cfrpg/Phibochilai-X/README.md

# Phibochilai X - "Kaniko"

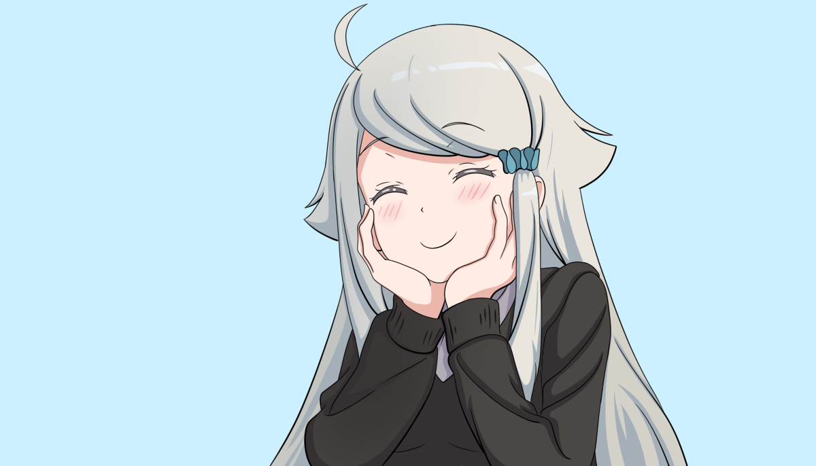
[picture p1: doc/65524353.jpg]
Image text


飞不起来10号

都出到10了吗?!

名字什么的先随便起一个好了

XFLR5 6.39

OpenVSP 3.13.1

CATIA V5r21

贴图：pid=65524353
