cfrpg/Phibochilai-X/cad/Structure/Deformation.png

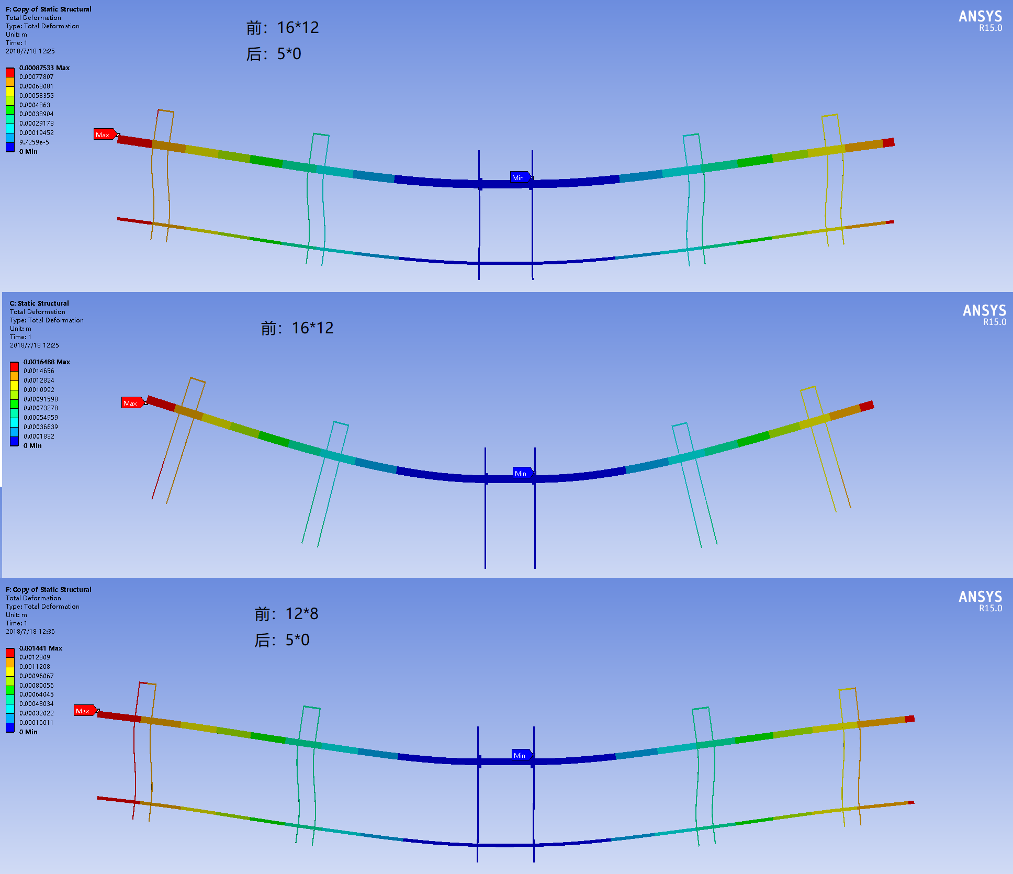
cad/Structure/Deformation.png
