cfrpg/Phibochilai-X/cad/法兰尺寸.png

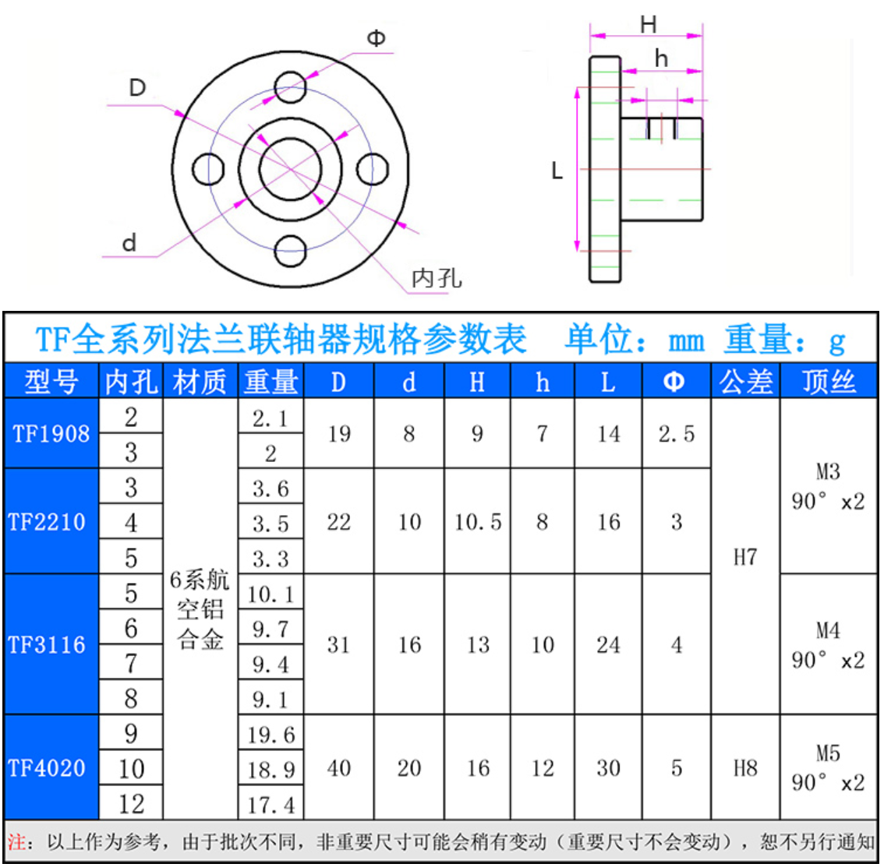
cad/法兰尺寸.png
