cfrpg/Phibochilai-X/doc/MotorMount.png

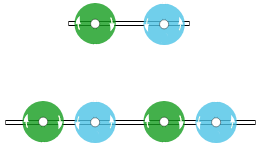
doc/MotorMount.png
