cfrpg/Phibochilai-X/vsp/kaniko.jpg

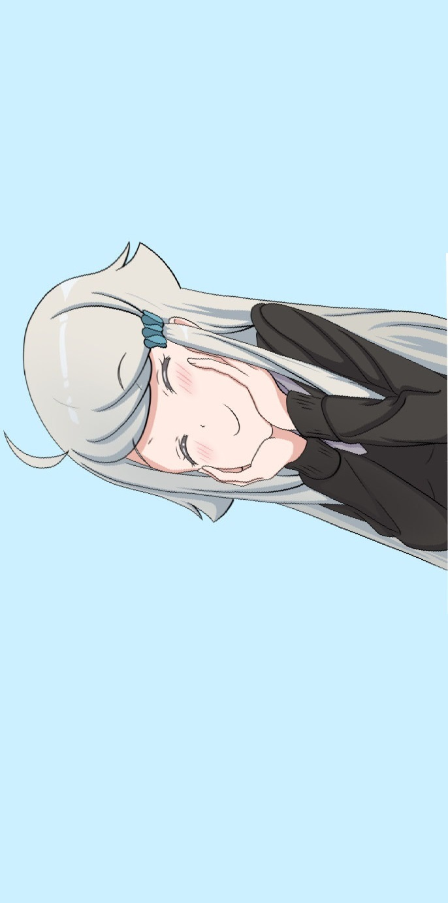
vsp/kaniko.jpg
