cfrpg/Phibochilai-X/doc/BOM.xlsx

Sheet: Sheet1
项目 | 型号 | 重量 | 数量 | 总重 | 单价 | 总价 | 含税 | 减重减配方案 | 备注
机翼电机 | TM 2214 | 60 | 6 | 360 | 599 | 1198 | 1317.8 | 没救 | 2.7kg@4s，买两套多两个或者买3套做两架
机翼电调 | TM 20A | 30 | 6 | 180 | 0 | 0 | 0 | 没救
机翼螺旋桨 | TM 1045 | 10 | 3 | 30 | 0 | 0 | 0 | 没救
舵面舵机 | 银燕ES3104 | 20 | 7 | 140 | 35 | 245 | 269.5 | 换成9g舵机 | 说不定用9g的就行
倾转套件 | 待定 | 50 | 2 | 100 | 300 | 600 | 660 | 可能还会增重 | 随便估算一下
接收机 | FUTABA R7008SB | 11 | 1 | 11 | 760 | 760 | 836 | 可以换成6303或者副厂
飞控 | Pixhawk(M8NGPS,数传电台) | 100 | 1 | 100 | 1422 | 1422 | 1564.2 | 乐迪Mini Pix有望轻几克
空速管 | 数字空速计 | 25 | 1 | 25 | 420 | 420 | 462 | 不装 | 破管子100多
电池 | 格氏4s5300mah 30c | 505 | 1 | 505 | 419 | 419 | 460.9 | 把电池里的铝板拆了 | 最好多买两块
电源 | 好盈UBEC 3A | 11 | 1 | 11 | 35 | 35 | 38.5 | 没救 | 不包括倾转用电力
起落架 | 起落架,机轮 | 50 | 1 | 50 | 20 | 20 | 22 | 自己拿kt板削 | 只留机轮
碳纤 | 碳纤管 | 400 | 1 | 400 | 300 | 300 | 330 | 设计高端结构 | 需要校核强度
板材 | 2mm kt板 | 33 | 10 | 330 | 10 | 100 | 110 | 大概可以铣薄减重？ | 2mm板，提高强度可以换成5mm打印店kt板
线材 | 电源线,信号线,插头等 | 250 | 1 | 250 | 50 | 50 | 55 | 没救 | 成吨的硅胶线
配件 | 螺丝,钢丝和轴承等 | 100 | 1 | 100 | 100 | 100 | 110 | 没救
3D打印耗材 | ABS，PLA，处理液 | 500 | 1 | 500 | 200 | 200 | 220 | 开减重孔 | 需要评估重量
其他耗材 | 胶水等 | 0 | 1 | 0 | 100 | 100 | 110 | 没救
总计 |  |  |  | 3092 |  | 5969 | 6565.9 |  | 这个重量真尴尬
假定超了20% |  |  |  | 3710.4
分类
动力 |  |  |  | 570 |  | 1198
电力 |  |  |  | 505 |  | 419
结构 |  |  |  | 1230 |  | 600
设备 |  |  |  | 437 |  | 3502
配件 |  |  |  | 350 |  | 250

Sheet: Sheet2
分类 | 项目 | 型号 | 单价 | 数量 | 总价 | 店铺 | 备注 | 链接
本体 | 舵面舵机 | ES3154 | 58 | 7 | 406 | 新动模型 |  | https://item.taobao.com/item.htm?spm=a1z10.3-c-s.w4002-14528659884.31.cd46829cfwxorK&id=21825583050
本体 | 动力电池 | 格氏4s5300mah30C | 419 | 2 | 838 | 新动模型 |  | https://item.taobao.com/item.htm?spm=a1z10.5-c-s.w4002-14528659934.20.4d405656KhgVBy&id=554987950181
本体 | 电源 | 好盈5V3A UBEC | 35 | 2 | 70 | 新动模型 |  | https://item.taobao.com/item.htm?spm=a1z10.3-c-s.w4002-14528659884.20.14e7829caOfjAF&id=567320340738
本体 | 接收机 | R6303SB | 425 | 1 | 425 | 朔天科技 |  | https://item.taobao.com/item.htm?spm=a1z0d.6639537.1997196601.26.302a7484ZEbE0i&id=559442696739
本体 | 倾转舵机 | JX 6221MG | 78 | 3 | 234 | 朔天科技 |  | https://item.taobao.com/item.htm?spm=a1z0d.6639537.1997196601.37.302a7484ZEbE0i&id=564749847613
本体 | 蜗轮蜗杆 | 待定 | 35 | 1 | 35 | 恒达传动 | 等舵机到货再买 | https://item.taobao.com/item.htm?spm=a230r.1.14.46.33266d23whc0w3&id=540207817197
本体 | 动力套 | TM 2214套装 | 649 | 2 | 1298 | TM专门店 |  | https://item.taobao.com/item.htm?spm=a1z10.5-c.w4002-4543554617.13.718966c6kBkGLw&id=23668976742
本体 | 飞控 | PixhackV3 | 1199 | 1 | 1199 | CUAV |  | https://item.taobao.com/item.htm?spm=a1z09.2.0.0.56292e8dlnoUTy&id=541167719476&_u=mmoj0iu0929
本体 | 空速计 | 全套 | 419 | 1 | 419 | CUAV |  | https://item.taobao.com/item.htm?id=9512463037&ns=1&abbucket=19
本体 | 数传 | 915mhz 250mw | 286 | 1 | 286 | CUAV |  | https://item.taobao.com/item.htm?spm=a1z09.2.0.0.56292e8dlnoUTy&id=15545763354&_u=mmoj0iu0bf3
材料 | 环氧 | 超级万能ab胶 | 10 | 1 | 10 | 新动模型 | orz | https://item.taobao.com/item.htm?spm=a1z0d.7625083.1998302264.5.686c4e69Y4uIfB&id=13570394121
材料 | 纤维胶带 | 30mm | 9 | 1 | 9 | 新动模型 |  | https://item.taobao.com/item.htm?spm=a1z10.5-c-s.w4002-14528659934.78.7bbcf351sMZeHS&id=13036166005
材料 | 热缩管 | 2mm | 0.5 | 2 | 1 | 新动模型 | 大口径的管够 | https://item.taobao.com/item.htm?spm=a1z10.5-c-s.w4002-14528659934.22.61a76a15HY9nIg&id=40865129513
材料 | 杜邦线 | 红黑白 | 1.5 | 10 | 15 | 新动模型 | 多多益善 | https://item.taobao.com/item.htm?spm=a1z10.5-c-s.w4002-14528659934.31.2228221cR54Bo0&id=14332242669
材料 | 电源线 | 16AWG | 2.35 | 6 | 14.1 | 新动模型 | 红黑 | https://item.taobao.com/item.htm?spm=a1z10.5-c-s.w4002-14528659934.37.6a2358c3eibgUb&id=14644636268
材料 | 电源线 | 18AWG | 1.65 | 4 | 6.6 | 新动模型 | 红黑 | https://item.taobao.com/item.htm?spm=a1z10.5-c-s.w4002-14528659934.37.6a2358c3eibgUb&id=14644636268
材料 | 泡沫板 | 2mm D板 | 54 | 2 | 108 | 添翼工作室 | 10张 | https://item.taobao.com/item.htm?spm=a1z10.5-c.w4002-844185206.18.1f9c14fcvGIe13&id=20099567300
材料 | 椴木层板 | 450*450*3 | 55 | 1 | 55 | 螃蟹王国 | 少量购买稍微贵点 | https://detail.tmall.com/item.htm?id=550455551745
材料 | 抛光液 | 500ml | 39 | 1 | 39 | 科瑞化工 | 当胶用 | https://item.taobao.com/item.htm?spm=a1z10.3-c.w4002-16599750469.23.eb1d69a0X7U7EI&id=561110898660
材料 | 泡沫胶 | UHU POR | 19.8 | 3 | 59.4 | XX办公 |  | https://detail.tmall.com/item.htm?id=15562625677&cm_id=140105335569ed55e27b&abbucket=19
材料 | 碳管 | 13*13*10 1m | 65 | 1 | 65 |  | 主梁内段 | https://item.taobao.com/item.htm?spm=a1z10.5-c.w4002-1768310787.59.6b6a6eabW4CycW&id=520294729905
材料 | 碳管 | 10*10*8 1m | 50 | 2 | 100 |  | 平尾粱，主梁外段 | https://item.taobao.com/item.htm?spm=a1z10.5-c.w4002-1768310787.47.6b6a6eabW4CycW&id=3938271944
材料 | 碳管 | 5*5*4 1m | 15 | 7 | 105 |  | 机身，后梁 | https://item.taobao.com/item.htm?spm=a1z0d.6639537.1997196601.4.16b274840PBlAP&id=13579665246
小配件 | 电池绑带 | 25cm | 2 | 1 | 2 | 新动模型 |  | https://item.taobao.com/item.htm?spm=a1z10.5-c-s.w4002-14528659934.62.7bbcf351sMZeHS&id=16015896454
小配件 | 电池插头 | XT60 | 3.2 | 4 | 12.8 | 新动模型 |  | https://item.taobao.com/item.htm?spm=a1z10.5-c-s.w4002-14528659934.57.5a57221ch5FilV&id=14867644853
小配件 | 分电板 |  | 3 | 1 | 3 | 新动模型 | 方便焊线 | https://item.taobao.com/item.htm?spm=a1z10.3-c-s.w4002-14528659884.11.5d76829cIV0MuB&id=13643634427
小配件 | 机轮 | 60*18,4mm | 3 | 4 | 12 | 新动模型 |  | https://item.taobao.com/item.htm?spm=a1z10.5-c-s.w4002-14528659934.23.40f772a7XnDLo2&id=13408709705
小配件 | 轮档 | 4.1mm | 0.6 | 5 | 3 | 新动模型 | 多买一个防止丢了 | https://item.taobao.com/item.htm?spm=a1z10.5-c-s.w4002-14528659934.19.40f772a7XnDLo2&id=14915104265
小配件 | 轮轴 | D4M5L27 | 3 | 4 | 12 | 新动模型 |  | https://item.taobao.com/item.htm?spm=a1z10.5-c-s.w4002-14528659934.31.40f772a7XnDLo2&id=14404690920
小配件 | 舵角套装 | 舵角+夹头 | 0.6 | 10 | 6 | 新动模型 |  | https://item.taobao.com/item.htm?spm=a1z10.5-c-s.w4002-14528659934.26.13e9121csnCs3k&id=18969440483
小配件 | 快调 | 1.6mm | 1 | 10 | 10 | 新动模型 |  | https://item.taobao.com/item.htm?spm=a1z10.5-c-s.w4002-14528659934.32.13e9121csnCs3k&id=13513525421
小配件 | 调直钢丝 | 1.2*65 | 14 | 1 | 14 | 新动模型 | 大概是10根 | https://item.taobao.com/item.htm?spm=a1z10.3-c-s.w4002-14528659884.10.560d829cXNa1HR&id=17062142989
小配件 | 螺母 | 20*M5 | 6 | 1 | 6 | 新动模型 | 轮轴用 | https://item.taobao.com/item.htm?spm=a1z10.3-c-s.w4002-14528659884.10.560d829cXNa1HR&id=17062142989
小配件 | 螺丝 | M3*8 | 0.45 | 30 | 13.5 | 新动模型 |  | https://item.taobao.com/item.htm?spm=a1z10.5-c-s.w4002-14528659934.80.dfc5526c4CaVA9&id=38307536599
小配件 | 螺丝 | M3*20 | 0.6 | 10 | 6 | 新动模型 | 连接用 | https://item.taobao.com/item.htm?spm=a1z10.5-c-s.w4002-14528659934.48.5dc3526cCjNvaT&id=14641396282
小配件 | 螺丝 | 10*M2*16 | 5 | 2 | 10 | 朔天科技 |  | https://item.taobao.com/item.htm?spm=a1z0d.6639537.1997196601.15.302a7484ZEbE0i&id=559596965276
小配件 | 螺母 | M2 | 100 | 0.02 | 2 | 朔天科技 |  | https://item.taobao.com/item.htm?spm=a1z0d.6639537.1997196601.4.302a7484ZEbE0i&id=565092035559
运费 |  |  | 20 | 1 | 20 | 添翼工作室
运费 |  |  | 7 | 1 | 7 | 新动模型
运费 |  |  | 26 | 1 | 26 | CUAV | 坑b卖家，记下了
总计 |  |  |  |  | 5962.4
