cfrpg/Phibochilai-X/doc/重量估算.xlsx

Sheet: 4s 2214配置
分项 |  | 质量(g) | 数量 | 总重(g) | 单价(CNY) | 总价(CNY) | 备注
电机 | TM 2214 | 60 | 4 | 240 | 0 | 599 | 2.2-4.8kg拉力@4s
电调 | TM20A | 30 | 4 | 120 | 0 | 0 | 套装
桨 | TM1045 | 10 | 4 | 40 | 0 | 0 | 套装
尾部电机 | 朗宇X2216 | 72 | 1 | 72 | 85 | 85 | 后出轴
尾部电调 | 好盈铂金40A | 40 | 1 | 40 | 143 | 143
舵面舵机 | 银燕9g塑料 | 10 | 7 | 70 | 17 | 119 | 有涨价的趋势
电池 | 格式4s5300 | 505 | 1 | 505 | 420 | 420 | 或2200*2,或4s
倾转舵机 | KST | 60 | 2 | 120 | 300 | 600 | 大扭力
飞控 | pix全套 | 150 | 1 | 150 | 1500 | 1500 | GPS空速管数传
尾部总成 | 自制(450级尾部) | 30 | 2 | 60 | 250 | 500 | 按照亚拓450估算的价格
碳 | 碳管 | 200 | 1 | 200 | 100 | 100 | 机翼梁和尾翼粱
钢 | 钢丝,轴 | 100 | 1 | 100 | 100 | 100 | 没有经验,难以估算
板 | 2mm kt板 | 33 | 10 | 330 | 10 | 100 | 大概需要10张,也有3mm的d板
3D打印件 | ABS | 400 | 1 | 400 | 60 | 60 | 初步估算重量,一卷耗材的价格
轴承 |  | 100 | 1 | 100 | 100 | 100 | 估算
胶 | UHU por,热熔胶等 | 40 | 1 | 40 | 25 | 25 | 用一管胶差不多够了
总计 |  |  |  | 2587 |  | 4451
考虑各种影响因素 |  |  |  | 3104.4 |  | 5341.2 | 超重,运费和发票20%
分类
动力 |  |  |  | 512 |  | 827
电力 |  |  |  | 505 |  | 420
机构 |  |  |  | 380 |  | 1300
电子设备 |  |  |  | 220 |  | 1619
结构 |  |  |  | 970 |  | 285

Sheet: 3508配置
分项 |  | 质量(g) | 数量 | 总重(g) | 单价(CNY) | 总价(CNY) | 备注
电机 | TM 3508 Kv700 | 82 | 4 | 328 | 399 | 1596 | 2.8(60%)-5.4kg(100%)推力
电调 | 好盈乐天40A | 30 | 4 | 120 | 62 | 248 | TM电调一个230,经费花不完可以换
桨 | TM12*4CF | 14 | 4 | 56 | 125 | 500 | emmmm,氪金帝都炸不起
尾部电机 | 朗宇X2216 | 72 | 1 | 72 | 85 | 85 | 后出轴
尾部电调 | 好盈铂金40A | 40 | 1 | 40 | 143 | 143
舵面舵机 | ES3104 | 20 | 7 | 140 | 35 | 245
电池 | 格式4s5300 | 505 | 1 | 505 | 420 | 420
倾转舵机 | KST | 70 | 2 | 140 | 400 | 800 | 大扭力
飞控 | pix全套 | 150 | 1 | 150 | 1500 | 1500 | GPS空速管数传
尾部总成 | 自制(450级尾部) | 30 | 2 | 60 | 250 | 500 | 按照亚拓450估算的价格
碳 | 碳管 | 200 | 1 | 200 | 100 | 100 | 机翼梁和尾翼粱
钢 | 钢丝,轴 | 100 | 1 | 100 | 100 | 100 | 没有经验,难以估算
板 | 2mm kt板 | 33 | 10 | 330 | 10 | 100 | 大概需要10张
3D打印件 | ABS | 500 | 1 | 500 | 60 | 60 | 初步估算重量,一卷耗材的价格
轴承 |  | 100 | 1 | 100 | 100 | 100 | 估算
胶 | UHU por,热熔胶等 | 40 | 1 | 40 | 25 | 25 | 用一管胶差不多够了
总计 |  |  |  | 2881 |  | 6522
考虑各种影响因素 |  |  |  | 3457.2 |  | 7826.4 | 超重,运费和发票20%
分类
动力 |  |  |  | 616 |  | 2572
电力 |  |  |  | 505 |  | 420
机构 |  |  |  | 400 |  | 1500
电子设备 |  |  |  | 290 |  | 1745
结构 |  |  |  | 1070 |  | 285

Sheet: u3配置
分项 |  | 质量(g) | 数量 | 总重(g) | 单价(CNY) | 总价(CNY) | 备注
电机 | TM U3 | 100 | 4 | 400 | 699 | 2796 | 4.0(60%)-7.2kg(100%)推力,动力澎湃
电调 | 好盈乐天40A | 30 | 4 | 120 | 62 | 248 | TM电调一个230,经费花不完可以换
桨 | TM13*4.4CF | 16 | 4 | 64 | 135 | 540 | emmmm,氪金帝都炸不起
尾部电机 | 朗宇X2820 | 143 | 1 | 143 | 150 | 150 | 后出轴
尾部电调 | 好盈飞腾60A | 70 | 1 | 70 | 200 | 200
舵面舵机 | ES3104 | 20 | 7 | 140 | 35 | 245
电池 | 格式4s5300 | 505 | 1 | 505 | 420 | 420
倾转舵机 | KST | 70 | 2 | 140 | 400 | 800 | 大扭力
飞控 | pix全套 | 150 | 1 | 150 | 1500 | 1500 | GPS空速管数传
尾部总成 | 自制(~700级尾部) | 60 | 2 | 120 | 400 | 800 | 可能需要大一点的尾桨
碳 | 碳管 | 300 | 1 | 300 | 100 | 100 | 机翼梁和尾翼粱
钢 | 钢丝,轴 | 100 | 1 | 100 | 100 | 100 | 没有经验,难以估算
板 | 2mm kt板 | 33 | 10 | 330 | 10 | 100 | 大概需要10张
3D打印件 | ABS | 600 | 1 | 600 | 60 | 60 | 初步估算重量,一卷耗材的价格
轴承 |  | 100 | 1 | 100 | 100 | 100 | 估算
胶 | UHU por,热熔胶等 | 40 | 1 | 40 | 25 | 25 | 用一管胶差不多够了
总计 |  |  |  | 3322 |  | 8184
考虑各种影响因素 |  |  |  | 3986.4 |  | 9820.8 | 超重,运费和发票20%
分类
动力 |  |  |  | 797 |  | 3934
电力 |  |  |  | 505 |  | 420
机构 |  |  |  | 460 |  | 1800
电子设备 |  |  |  | 290 |  | 1745
结构 |  |  |  | 1270 |  | 285
