cfrpg/Phibochilai-X/cad/3DPrint/GearFrame.stl

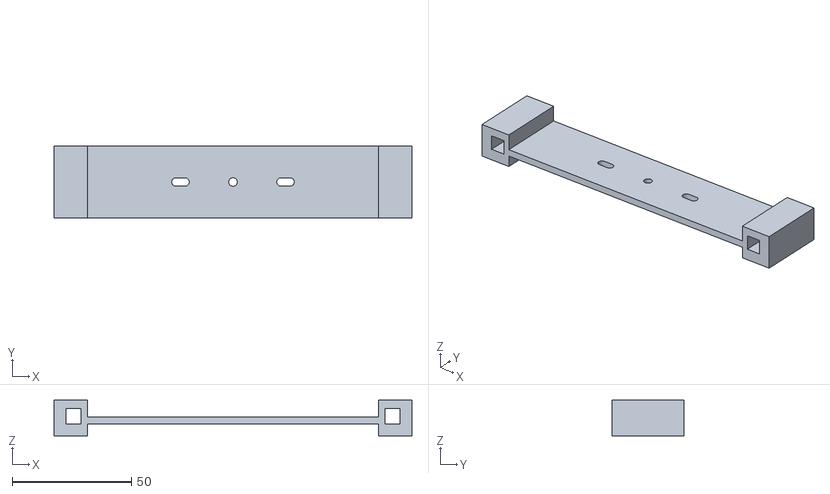
[picture p17: CAD file, 2018-12-05]
cad/3DPrint/GearFrame.stl
150.0 x 30.0 x 15.0
