cfrpg/Phibochilai-X/cad/3DPrint/servo/holder3.stl

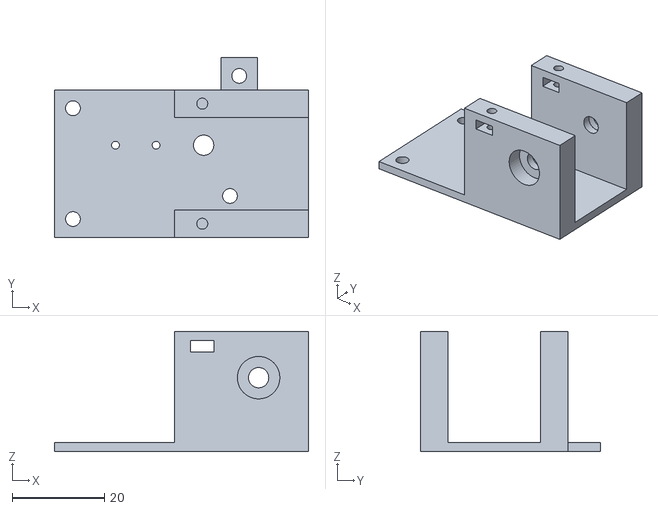
[picture p18: CAD file, 2018-12-05]
cad/3DPrint/servo/holder3.stl
55.0 x 39.0 x 26.0
