cfrpg/Phibochilai-X/cad/3DPrint/test/fakeWingFrame.stl

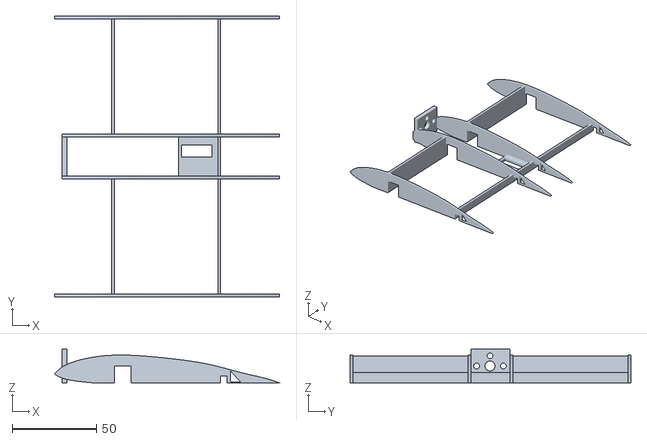
[picture p19: CAD file, 2018-07-22]
cad/3DPrint/test/fakeWingFrame.stl
133.5 x 166.6 x 20.0
