cfrpg/Phibochilai-X/cad/3DPrint/test/fakeWingSet/fakebeam.stl

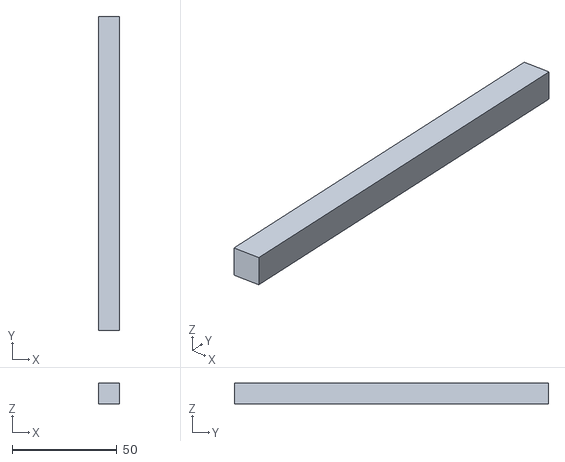
[picture p20: CAD file, 2018-03-03]
cad/3DPrint/test/fakeWingSet/fakebeam.stl
10.0 x 150.0 x 10.0
