cfrpg/Phibochilai-X/cad/3DPrint/TiltFrame/servoFrame.stl

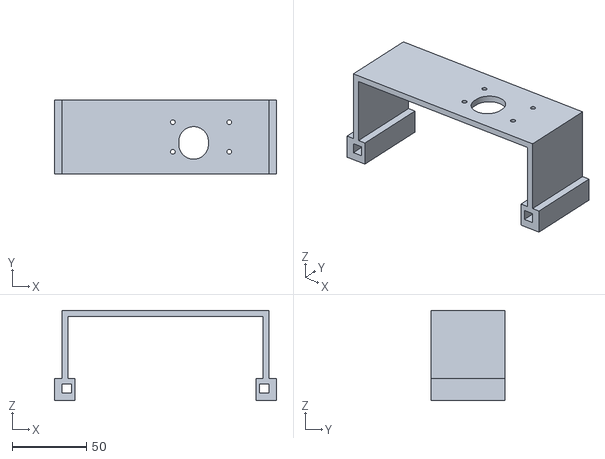
[picture p21: CAD file, 2018-10-30]
cad/3DPrint/TiltFrame/servoFrame.stl
150.0 x 50.0 x 61.0
