cfrpg/Phibochilai-X/cad/model/model.igs

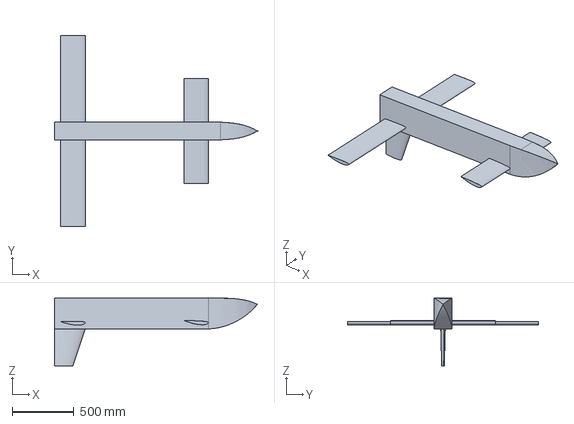
[picture p22: CAD file, 2018-10-06]
cad/model/model.igs
1650.0 x 1550.0 x 550.0 mm
