cfrpg/Phibochilai-X/cad/3DPrint/gearMount.stl

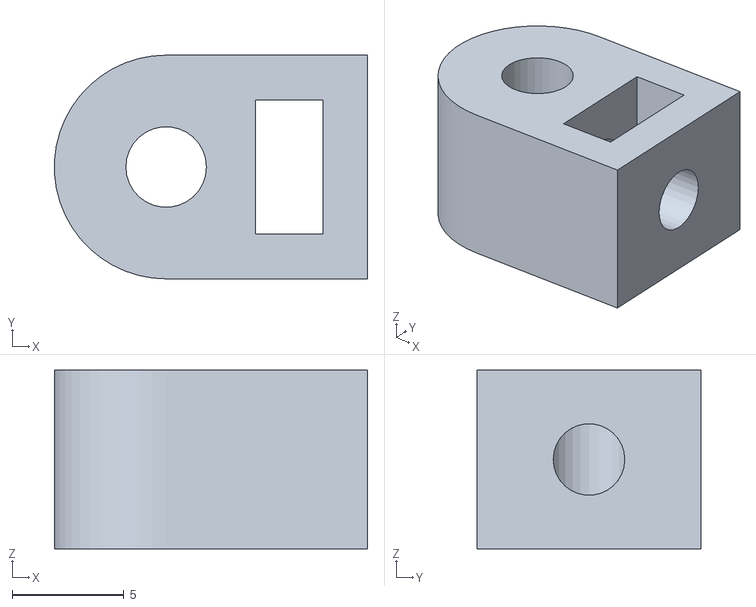
[picture p23: CAD file, 2018-12-05]
cad/3DPrint/gearMount.stl
14.0 x 10.0 x 8.00
