cfrpg/Phibochilai-X/cad/3DPrint/servo/pdGear.stl

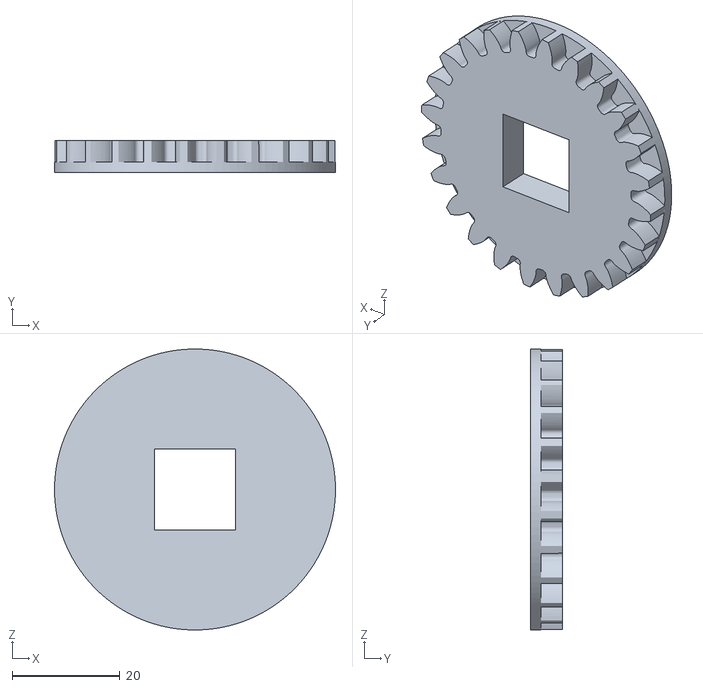
[picture p24: CAD file, 2018-12-05]
cad/3DPrint/servo/pdGear.stl
52.0 x 6.00 x 52.0
