cfrpg/Phibochilai-X/cad/3DPrint/test/compMount.stl

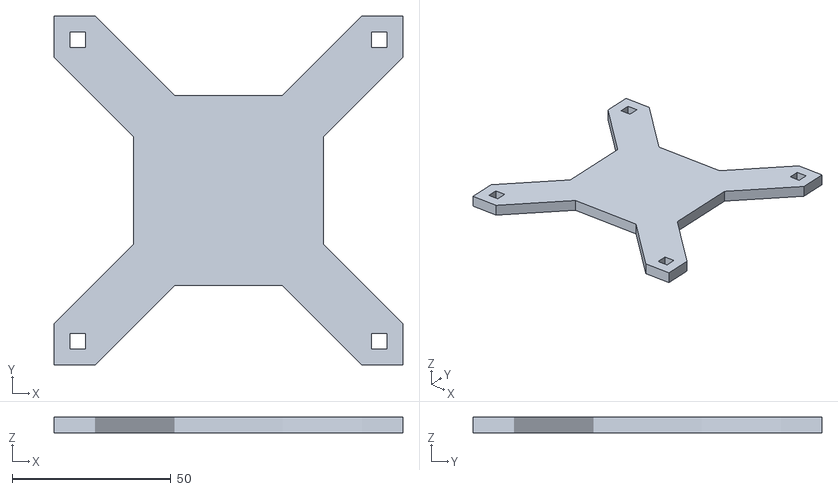
[picture p25: CAD file, 2018-07-15]
cad/3DPrint/test/compMount.stl
110.0 x 110.0 x 5.00
