cfrpg/Phibochilai-X/cad/3DPrint/test/fakeWingSet/fakesleevecap.stl

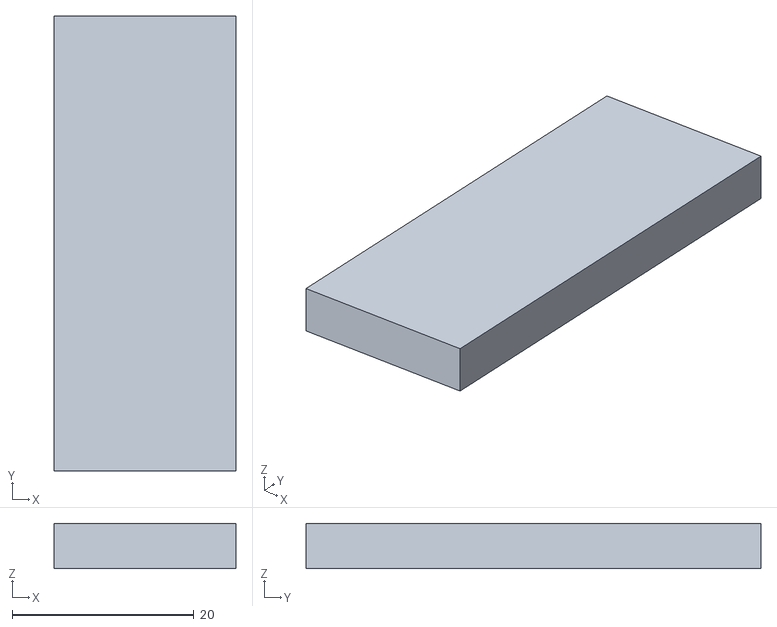
[picture p26: CAD file, 2018-03-03]
cad/3DPrint/test/fakeWingSet/fakesleevecap.stl
20.0 x 50.0 x 5.00
