cfrpg/Phibochilai-X/cad/3DPrint/TiltFrame/aaa.stl

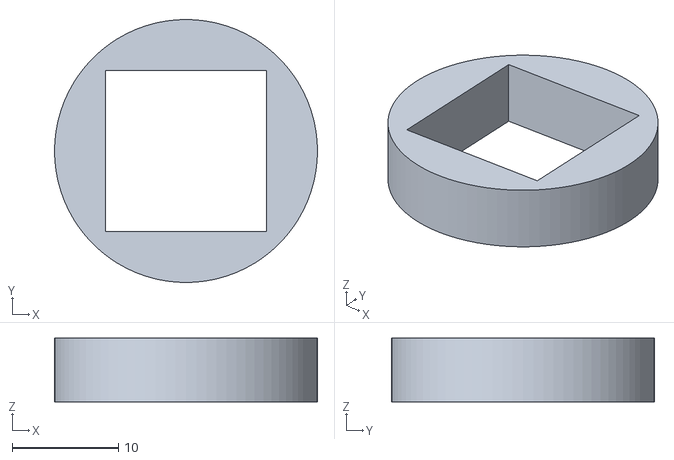
[picture p27: CAD file, 2018-10-30]
cad/3DPrint/TiltFrame/aaa.stl
24.8 x 24.8 x 6.00
