cfrpg/Phibochilai-X/cad/3DPrint/servo/base3.stl

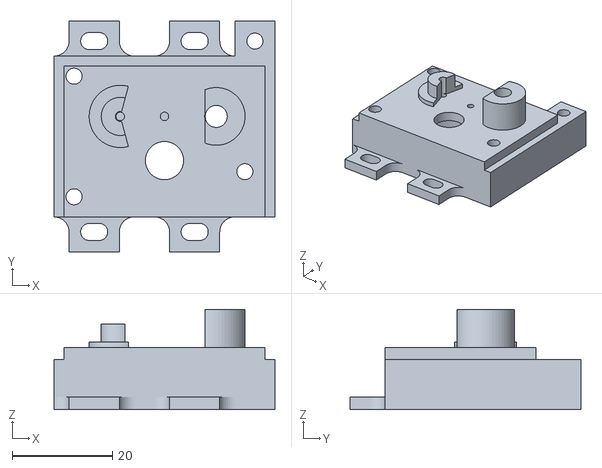
[picture p28: CAD file, 2018-12-05]
cad/3DPrint/servo/base3.stl
44.0 x 46.0 x 20.0
