cfrpg/Phibochilai-X/cad/3DPrint/test/fakeWingSet/fakesleeve.stl

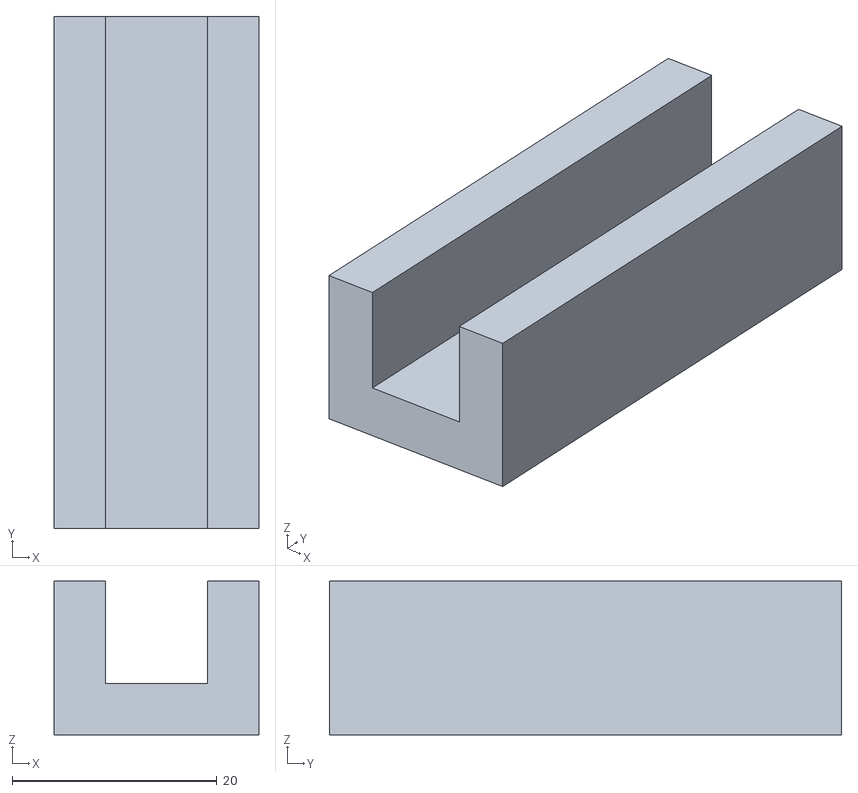
[picture p29: CAD file, 2018-03-03]
cad/3DPrint/test/fakeWingSet/fakesleeve.stl
20.0 x 50.0 x 15.0
