cfrpg/Phibochilai-X/cad/3DPrint/test/strengthTest.stl

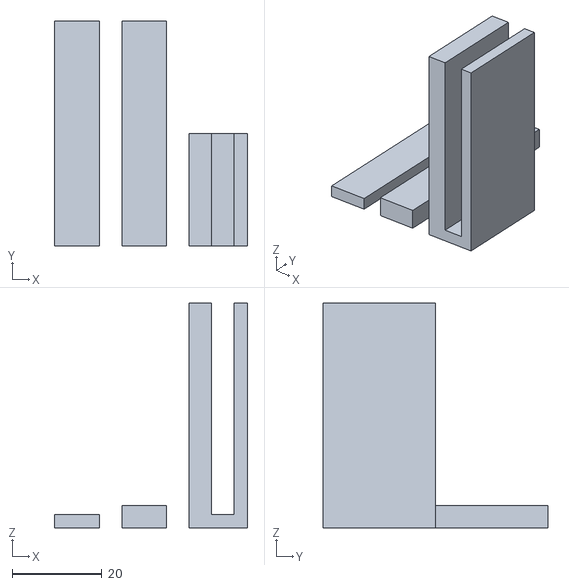
[picture p30: CAD file, 2018-07-15]
cad/3DPrint/test/strengthTest.stl
43.0 x 50.0 x 50.0
