cfrpg/Phibochilai-X/cad/3DPrint/TiltFrame/BodyFrame.stl

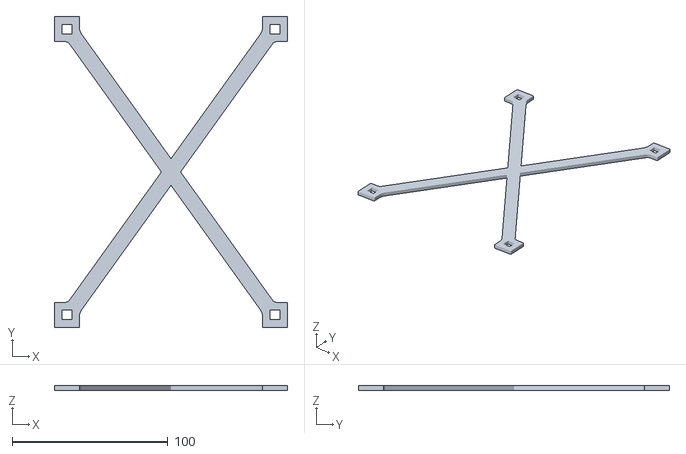
[picture p31: CAD file, 2018-10-30]
cad/3DPrint/TiltFrame/BodyFrame.stl
150.0 x 200.0 x 3.00
