cfrpg/Phibochilai-X/cad/3DPrint/wingGear.stl

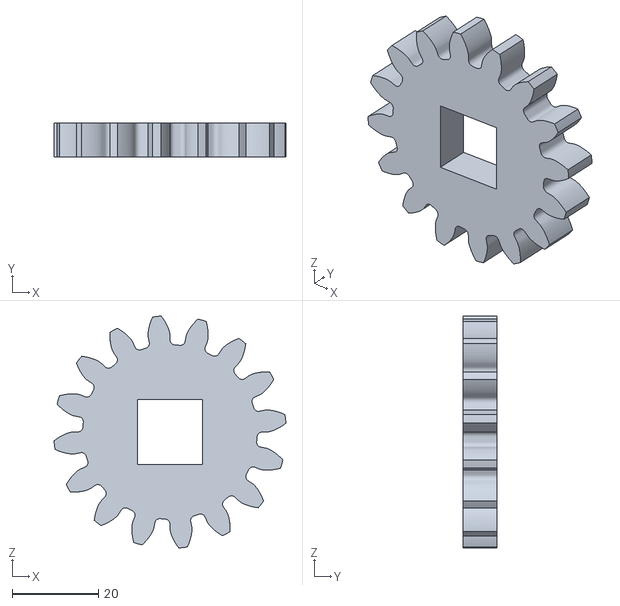
[picture p32: CAD file, 2018-12-05]
cad/3DPrint/wingGear.stl
53.8 x 8.00 x 53.8
