cfrpg/Phibochilai-X/cad/3DPrint/BatteryFrame.stl

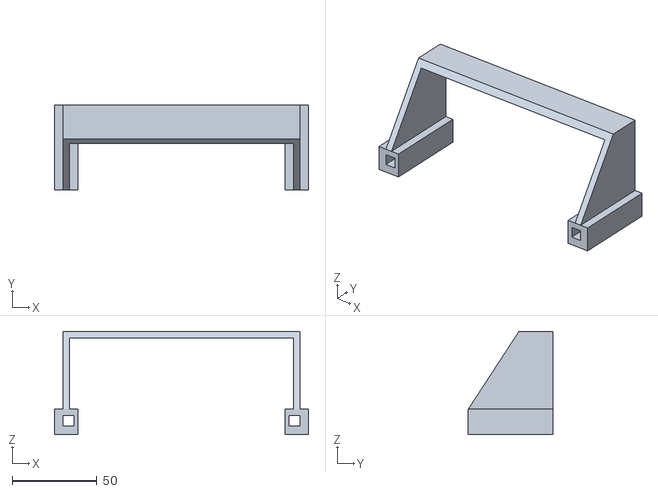
[picture p33: CAD file, 2018-12-05]
cad/3DPrint/BatteryFrame.stl
150.0 x 50.0 x 61.0
