cfrpg/Phibochilai-X/cad/3DPrint/servo/cap3.stl

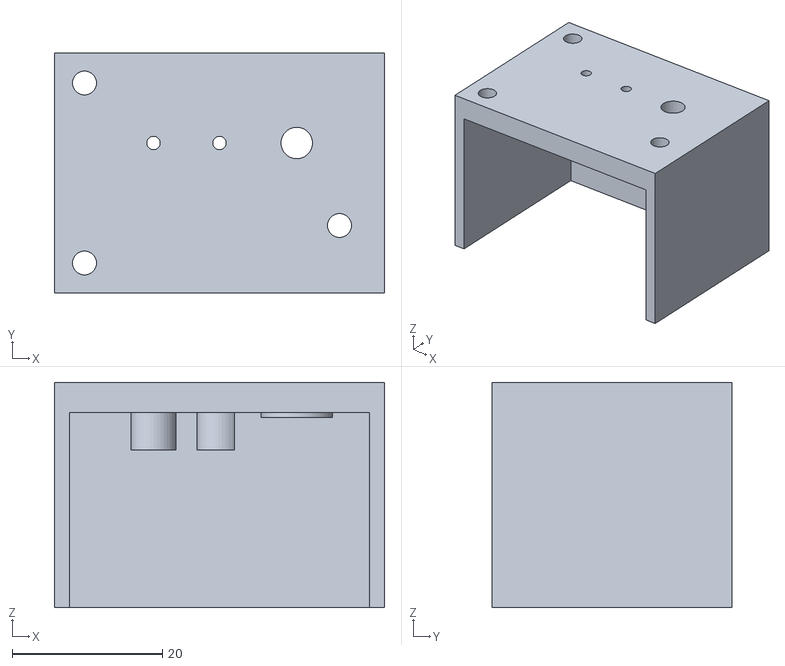
[picture p34: CAD file, 2018-12-05]
cad/3DPrint/servo/cap3.stl
44.0 x 32.0 x 30.0
