cfrpg/Phibochilai-X/cad/3DPrint/test/fakeBodyPart.stl

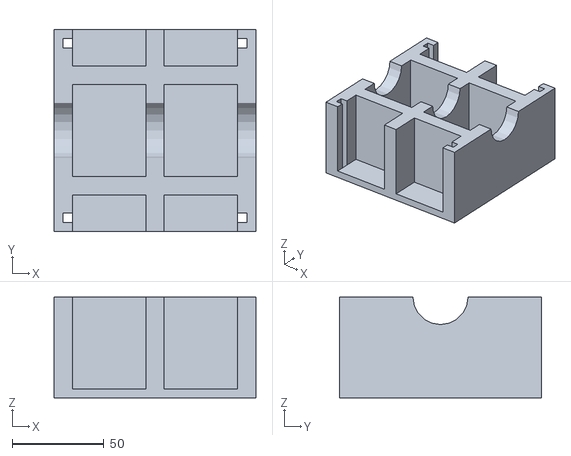
[picture p35: CAD file, 2018-07-15]
cad/3DPrint/test/fakeBodyPart.stl
110.0 x 110.0 x 55.0
