cfrpg/Phibochilai-X/cad/3DPrint/test/fakeWingSet/reinforcedRib.stl

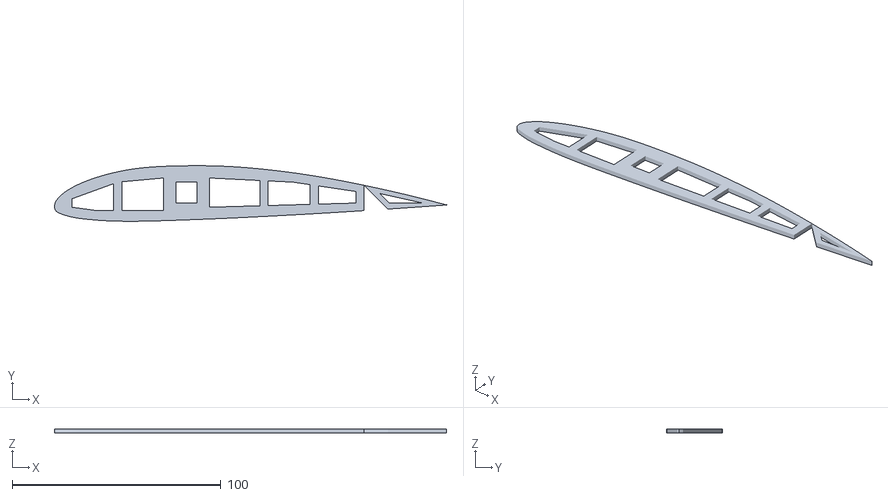
[picture p36: CAD file, 2018-03-03]
cad/3DPrint/test/fakeWingSet/reinforcedRib.stl
187.7 x 26.6 x 2.00
