cfrpg/Phibochilai-X/cad/3DPrint/TiltFrame/pdMount.stl

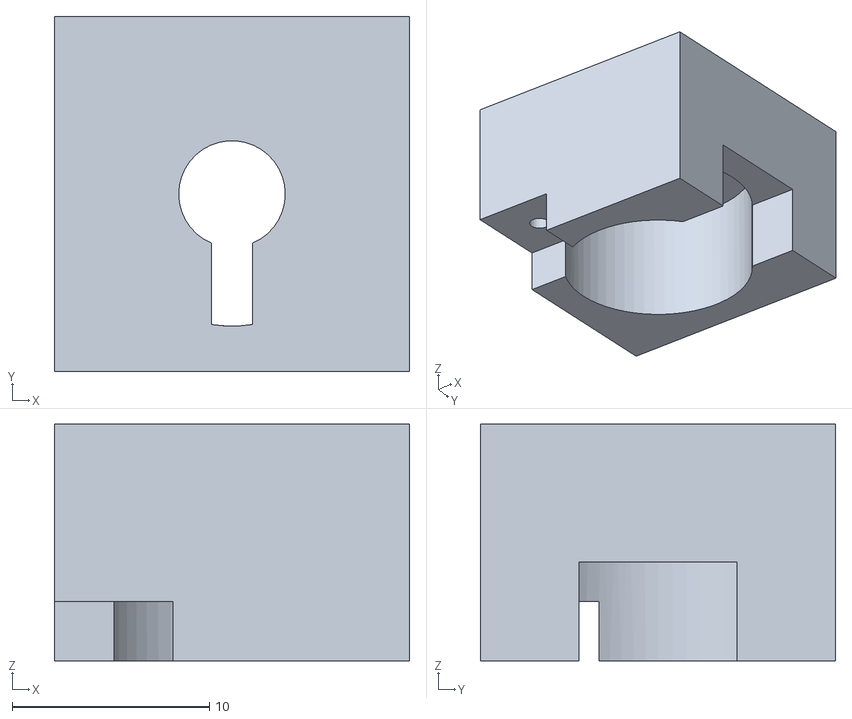
[picture p37: CAD file, 2018-10-30]
cad/3DPrint/TiltFrame/pdMount.stl
18.0 x 18.0 x 12.0
