cfrpg/Phibochilai-X/cad/3DPrint/servo/top.stl

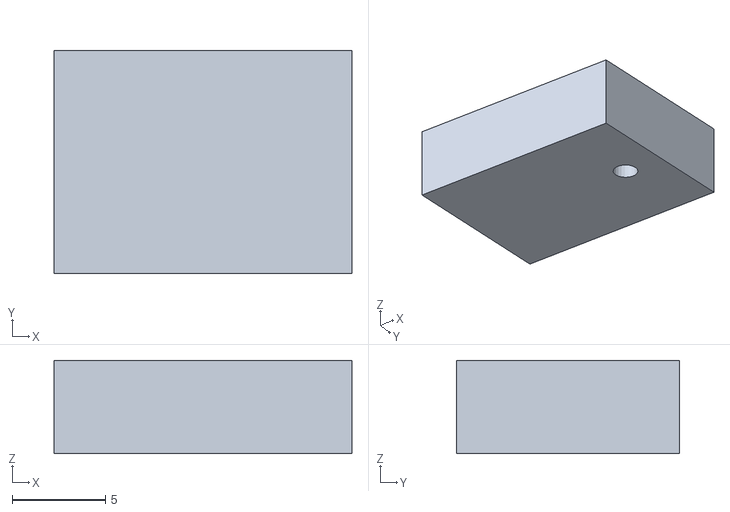
[picture p38: CAD file, 2018-12-05]
cad/3DPrint/servo/top.stl
16.0 x 12.0 x 5.00
