cfrpg/Phibochilai-X/cad/3DPrint/test/22MotorMount.stl

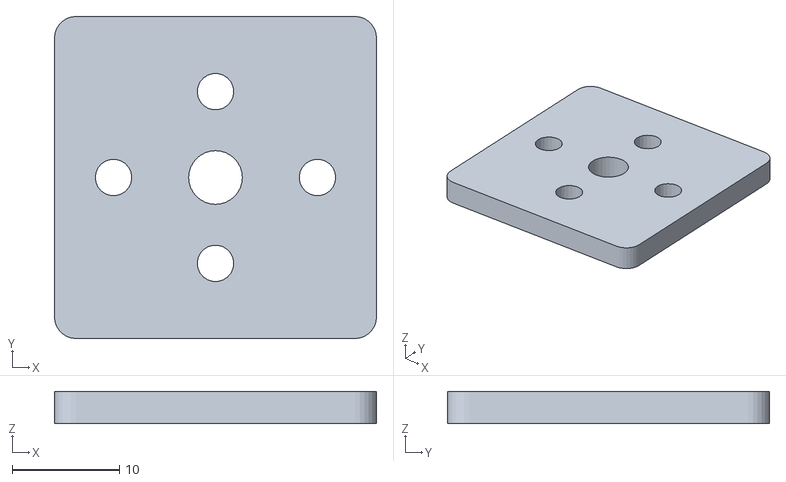
[picture p39: CAD file, 2018-07-15]
cad/3DPrint/test/22MotorMount.stl
30.0 x 30.0 x 3.00
