cfrpg/Phibochilai-X/cad/3DPrint/test/fakeWingSet/tiltgear.stl

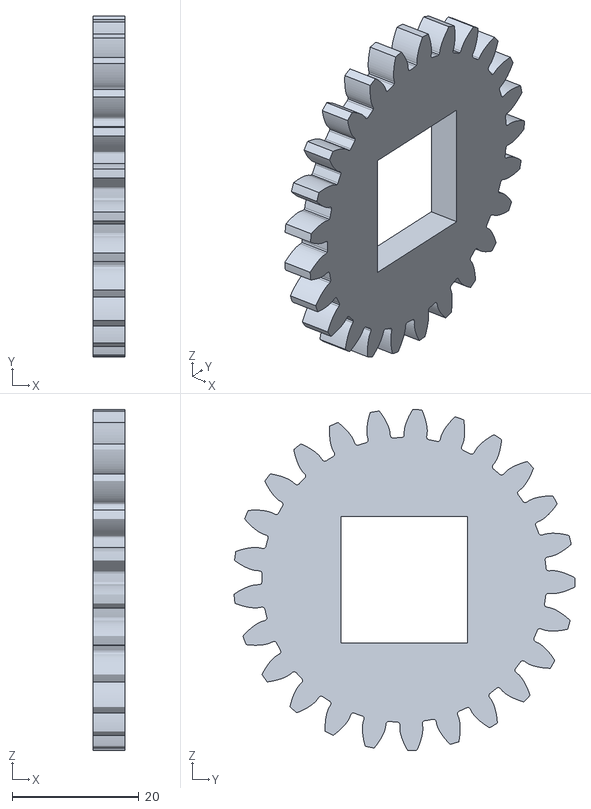
[picture p40: CAD file, 2018-03-03]
cad/3DPrint/test/fakeWingSet/tiltgear.stl
5.00 x 53.9 x 54.0
