cfrpg/Phibochilai-X/cad/3DPrint/TiltFrame/WingFrame.stl

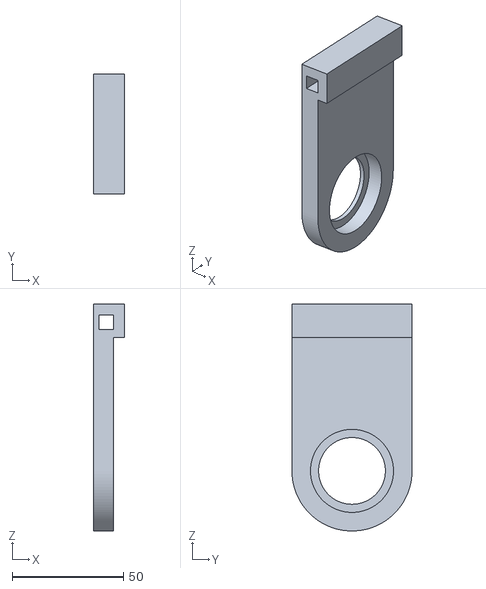
[picture p41: CAD file, 2018-10-30]
cad/3DPrint/TiltFrame/WingFrame.stl
14.0 x 54.0 x 102.0
