cfrpg/Phibochilai-X/cad/3DPrint/Vtail7.stl

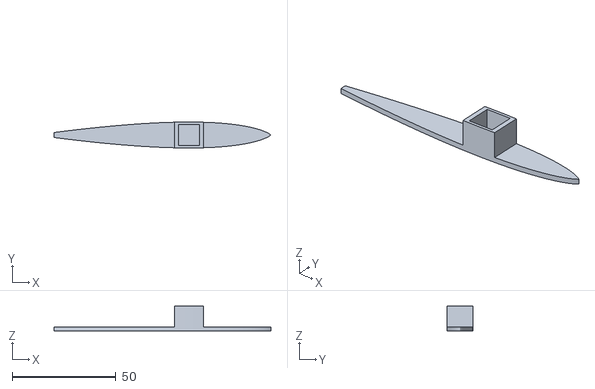
[picture p42: CAD file, 2018-11-18]
cad/3DPrint/Vtail7.stl
104.6 x 12.5 x 12.0
