cfrpg/Phibochilai-X/cad/3DPrint/servo/pdSmallGear.stl

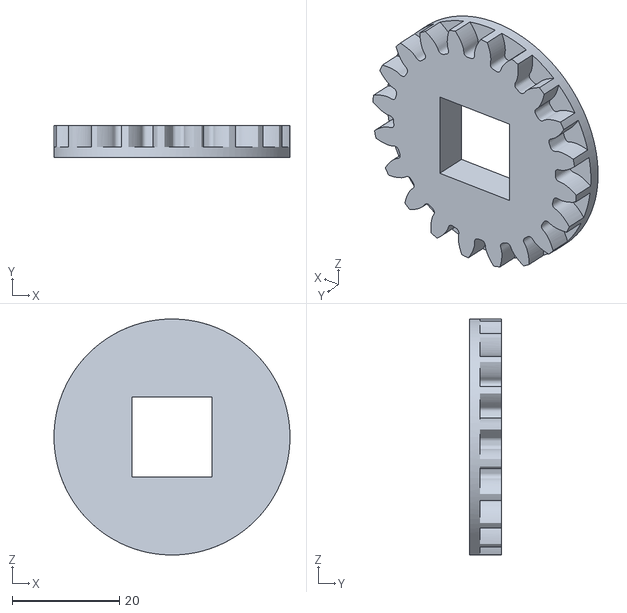
[picture p43: CAD file, 2018-12-05]
cad/3DPrint/servo/pdSmallGear.stl
44.0 x 6.00 x 44.0
