cfrpg/Phibochilai-X/cad/3DPrint/test/gear.stl

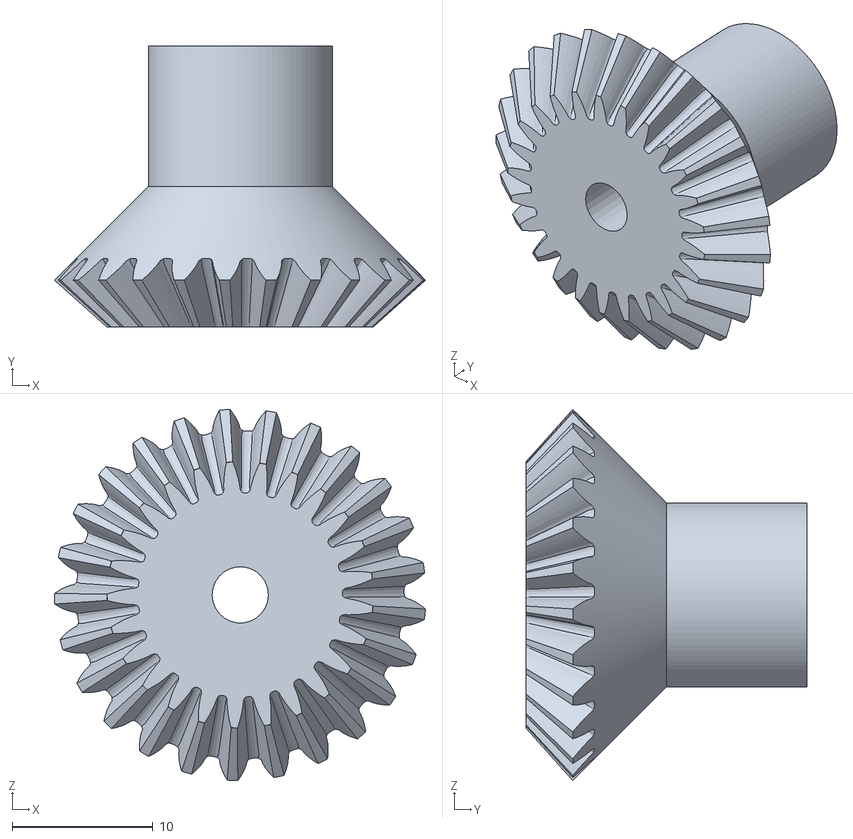
[picture p44: CAD file, 2018-03-03]
cad/3DPrint/test/gear.stl
26.4 x 20.0 x 26.4
