cfrpg/Phibochilai-X/cad/3DPrint/Vtail1.stl

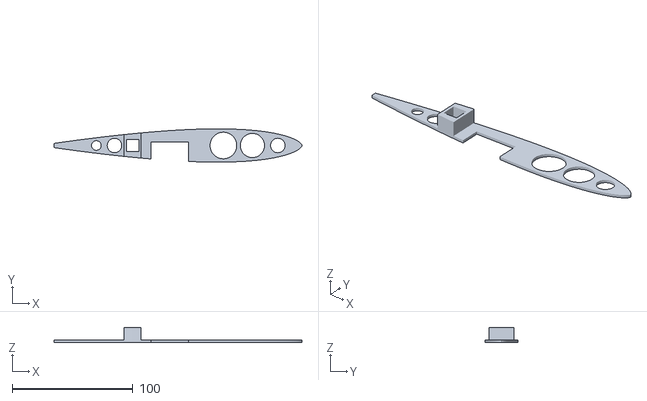
[picture p45: CAD file, 2018-11-18]
cad/3DPrint/Vtail1.stl
205.0 x 27.5 x 12.0
