cfrpg/Phibochilai-X/cad/3DPrint/circlip.stl

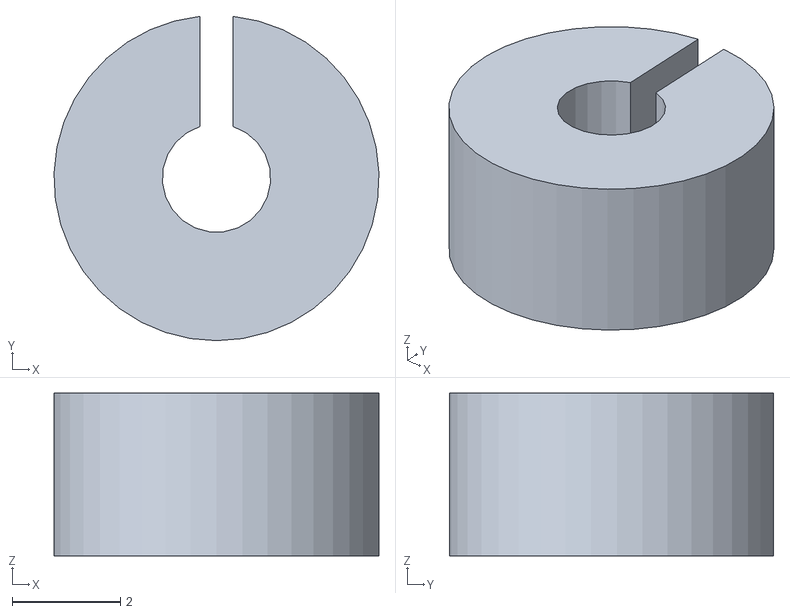
[picture p46: CAD file, 2018-11-18]
cad/3DPrint/circlip.stl
6.00 x 5.98 x 3.00
