cfrpg/Phibochilai-X/cad/3DPrint/TiltFrame.stl

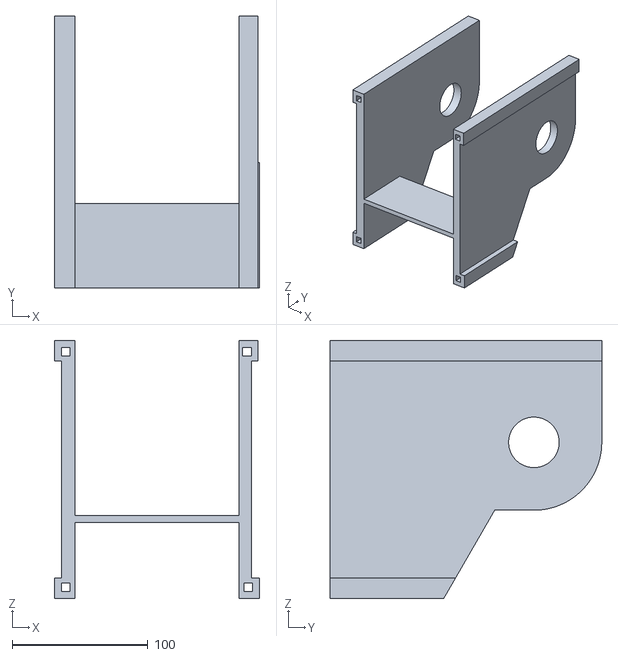
[picture p47: CAD file, 2018-10-30]
cad/3DPrint/TiltFrame.stl
151.0 x 200.0 x 190.0
