cfrpg/Phibochilai-X/cad/3DPrint/bc.stl

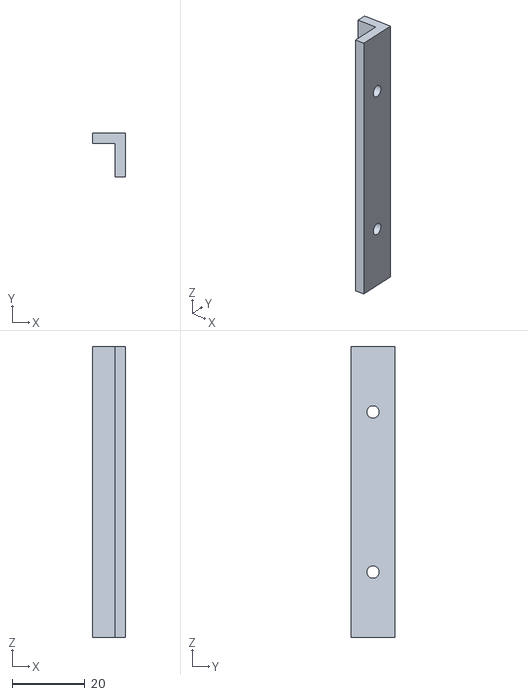
[picture p48: CAD file, 2018-10-06]
cad/3DPrint/bc.stl
9.10 x 12.0 x 80.0
