cfrpg/Phibochilai-X/cad/3DPrint/servo/pdShaft.stl

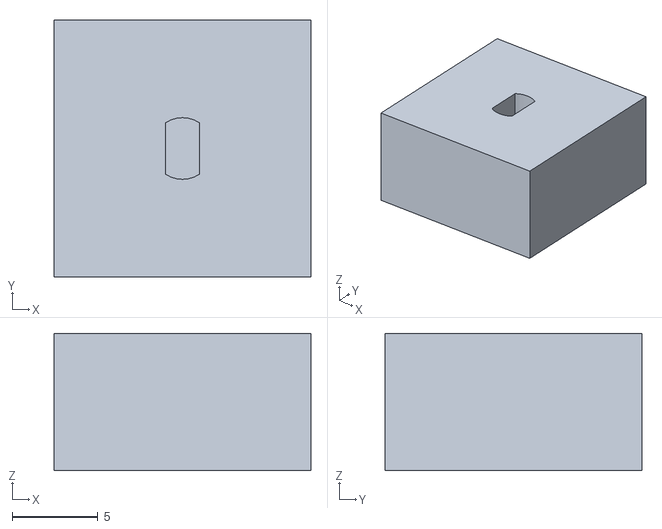
[picture p49: CAD file, 2018-10-30]
cad/3DPrint/servo/pdShaft.stl
15.0 x 15.0 x 8.00
