cfrpg/Phibochilai-X/cad/3DPrint/biggear.stl

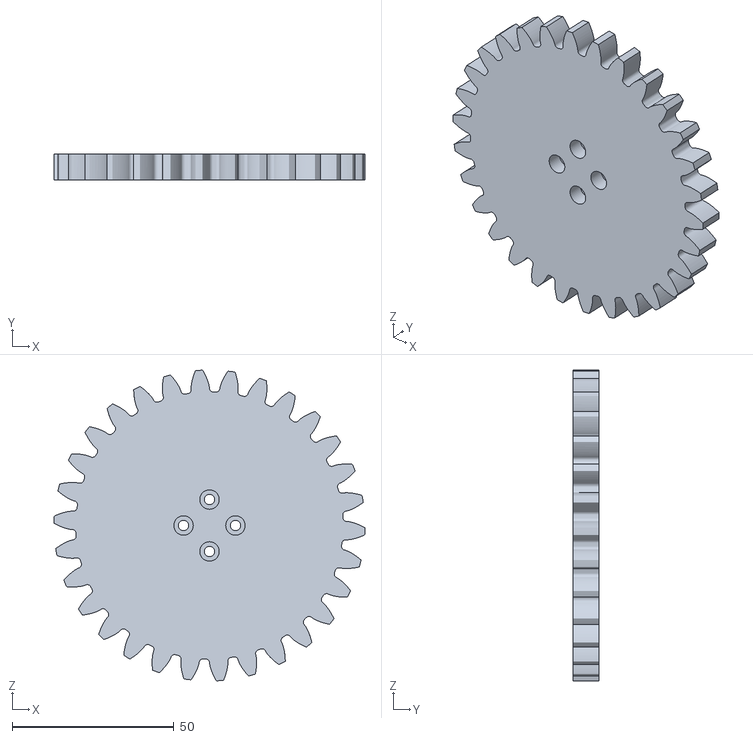
[picture p50: CAD file, 2018-10-06]
cad/3DPrint/biggear.stl
96.0 x 8.00 x 95.9
