cfrpg/Phibochilai-X/cad/3DPrint/servo/top1.stl

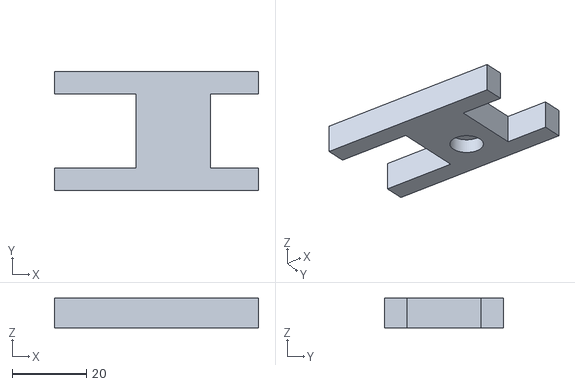
[picture p51: CAD file, 2018-10-06]
cad/3DPrint/servo/top1.stl
55.0 x 32.0 x 8.00
