cfrpg/Phibochilai-X/cad/3DPrint/tsbase.stl

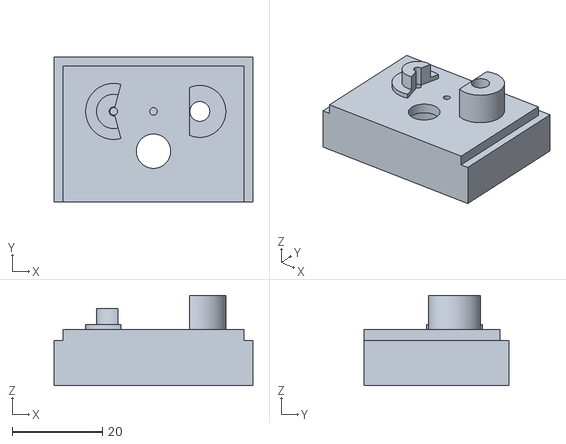
[picture p52: CAD file, 2018-09-02]
cad/3DPrint/tsbase.stl
44.0 x 32.0 x 20.0
