cfrpg/Phibochilai-X/cad/3DPrint/servo/bottom.stl

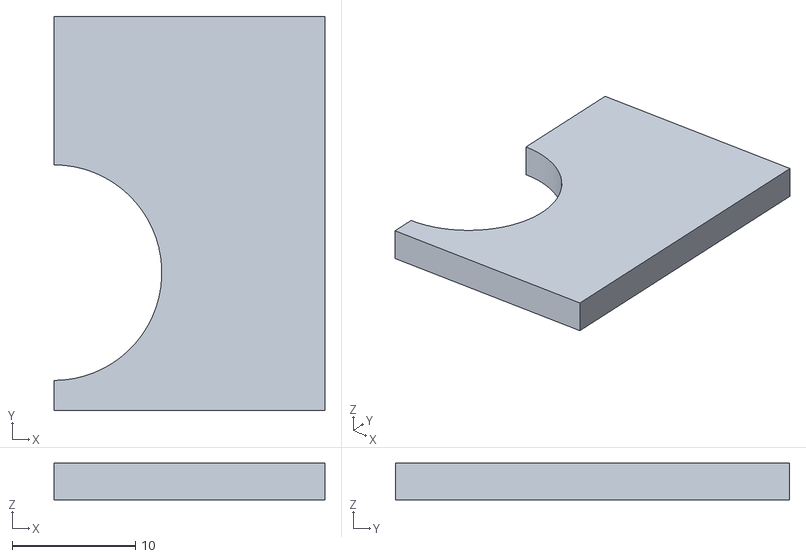
[picture p53: CAD file, 2018-10-06]
cad/3DPrint/servo/bottom.stl
22.0 x 32.0 x 3.00
