cfrpg/Phibochilai-X/cad/3DPrint/tscap.stl

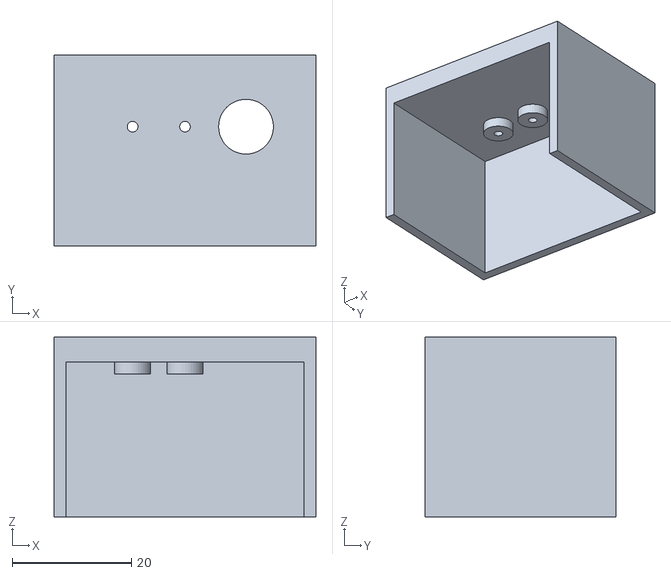
[picture p54: CAD file, 2018-09-02]
cad/3DPrint/tscap.stl
44.0 x 32.0 x 30.2
