cfrpg/Phibochilai-X/cad/3DPrint/servo/test.stl

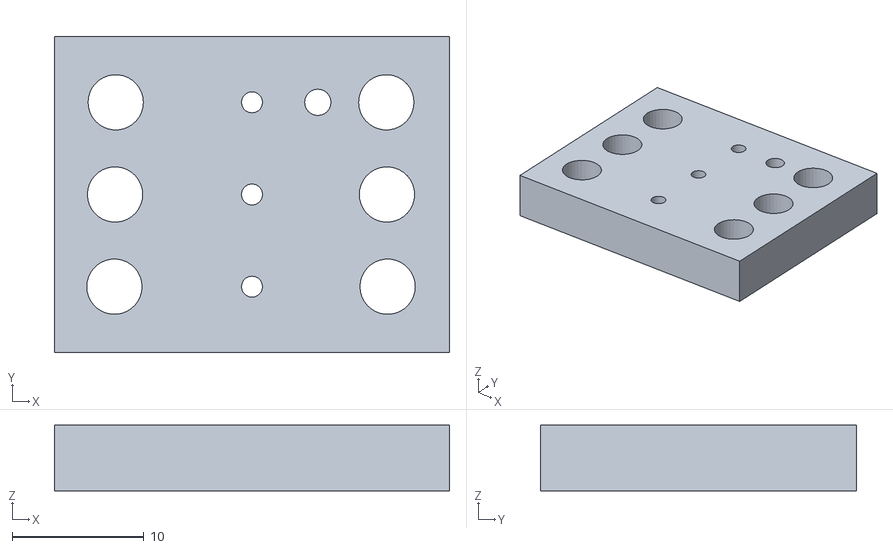
[picture p55: CAD file, 2018-10-06]
cad/3DPrint/servo/test.stl
30.0 x 24.0 x 5.00
