cfrpg/Phibochilai-X/cad/3DPrint/tssp.stl

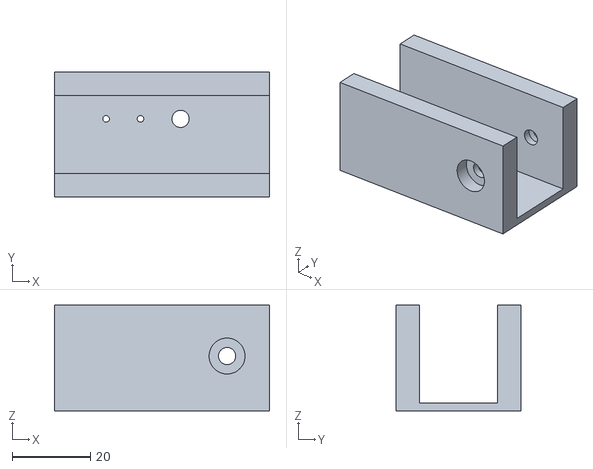
[picture p56: CAD file, 2018-08-27]
cad/3DPrint/tssp.stl
55.0 x 32.0 x 27.0
