cfrpg/Phibochilai-X/cad/3DPrint/hole.stl

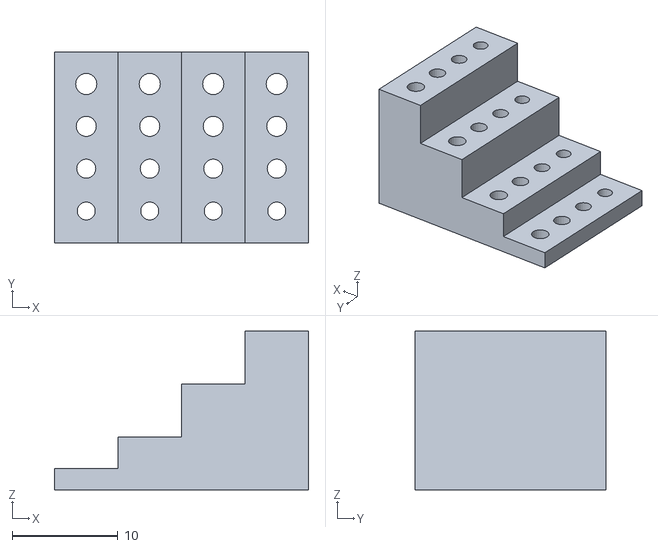
[picture p57: CAD file, 2018-08-27]
cad/3DPrint/hole.stl
24.0 x 18.0 x 15.0
