cfrpg/Phibochilai-X/cad/3DPrint/servo/holder.stl

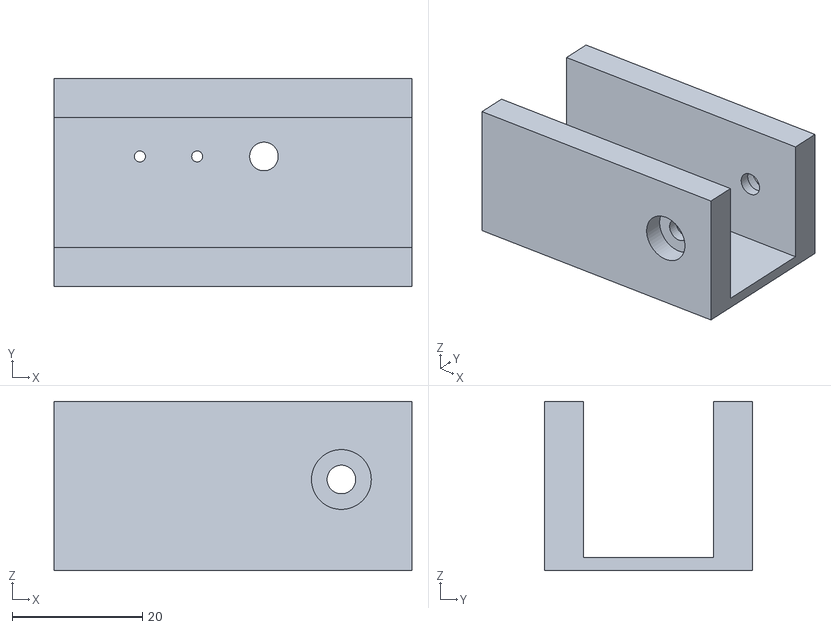
[picture p58: CAD file, 2018-10-06]
cad/3DPrint/servo/holder.stl
55.0 x 32.0 x 26.0
