cfrpg/Phibochilai-X/cad/3DPrint/aile1.stl

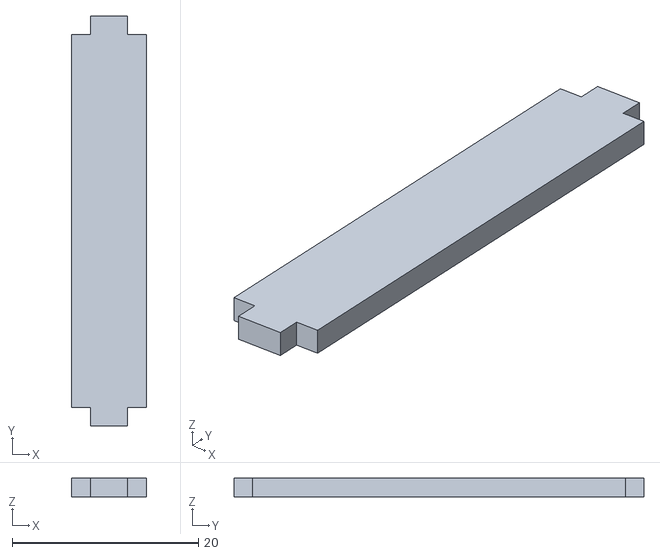
[picture p59: CAD file, 2018-08-24]
cad/3DPrint/aile1.stl
8.00 x 44.0 x 2.00
