cfrpg/Phibochilai-X/cad/3DPrint/servo/top2.stl

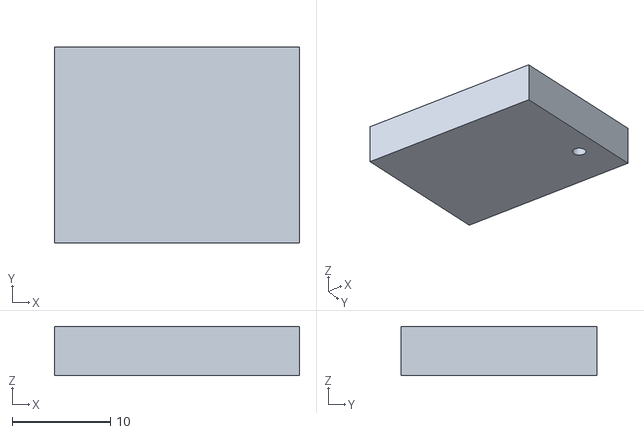
[picture p60: CAD file, 2018-10-06]
cad/3DPrint/servo/top2.stl
25.0 x 20.0 x 5.00
