cfrpg/Phibochilai-X/cad/3DPrint/servo.stl

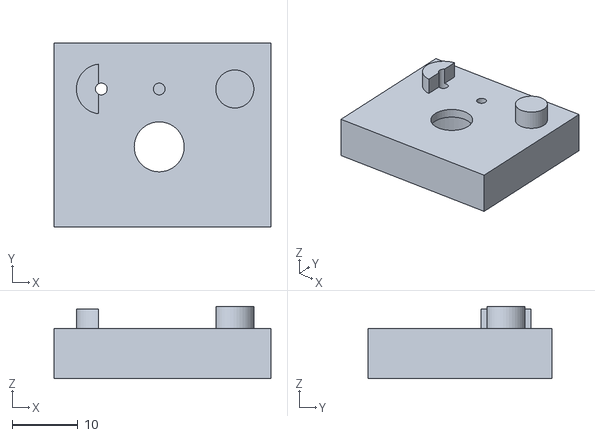
[picture p61: CAD file, 2018-08-24]
cad/3DPrint/servo.stl
33.0 x 28.0 x 11.0
