cfrpg/Phibochilai-X/cad/3DPrint/servo/cap.stl

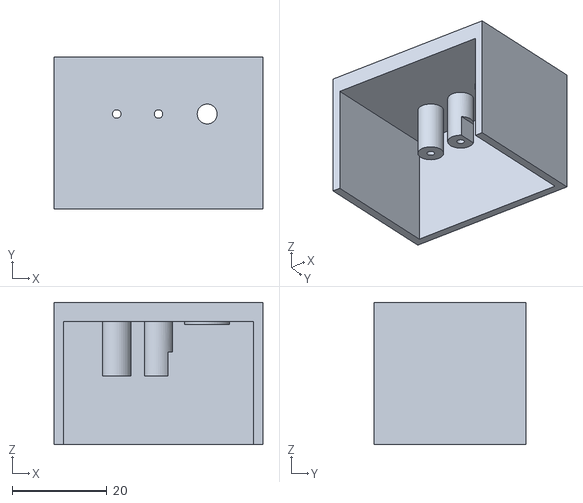
[picture p62: CAD file, 2018-10-06]
cad/3DPrint/servo/cap.stl
44.0 x 32.0 x 30.0
