cfrpg/Phibochilai-X/cad/3DPrint/aile.stl

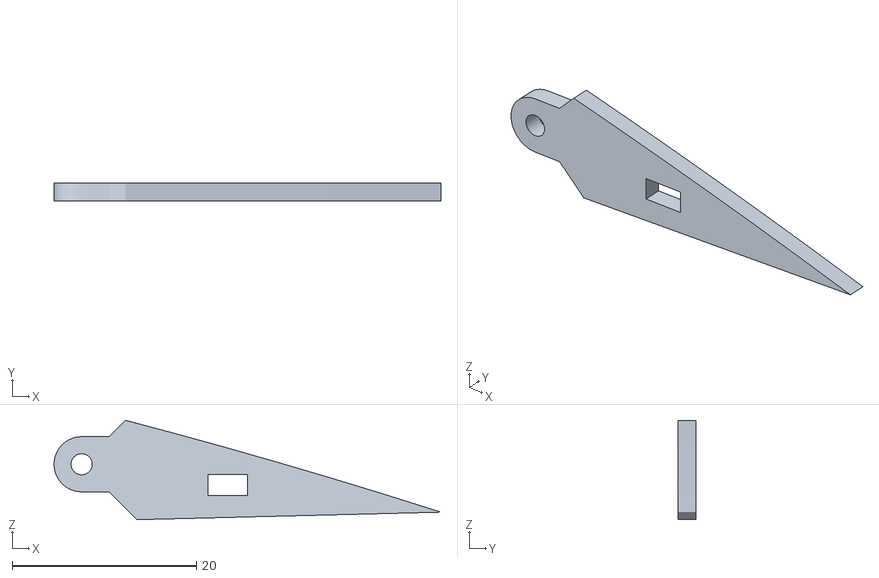
[picture p63: CAD file, 2018-08-24]
cad/3DPrint/aile.stl
42.0 x 2.00 x 10.8
