cfrpg/Phibochilai-X/cad/3DPrint/aile2.stl

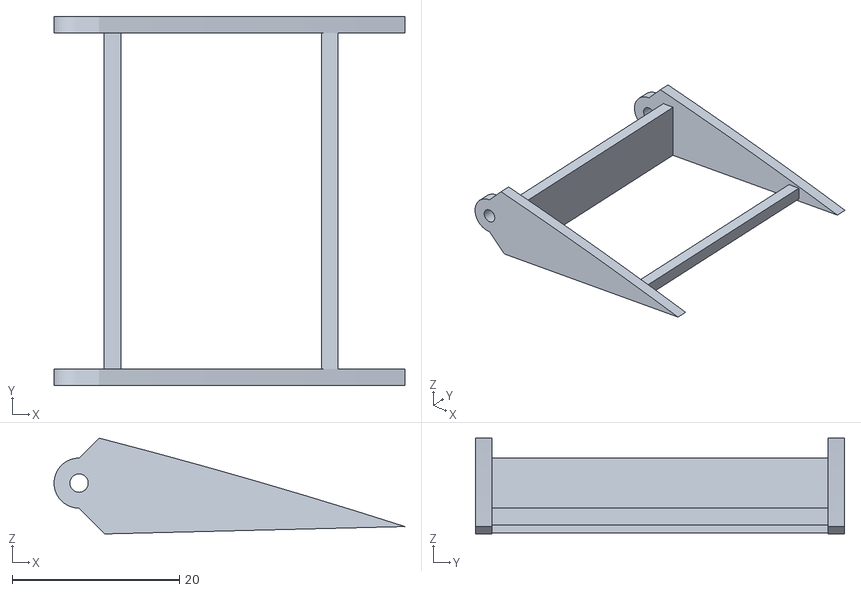
[picture p64: CAD file, 2018-08-24]
cad/3DPrint/aile2.stl
42.0 x 44.2 x 11.5
