cfrpg/Phibochilai-X/(list of files, cad)

Other CAD files:
cad/model/model2.igs
cad/3DPrint/servo/pdGear2.stl
cad/3DPrint/servo/pdMount.stl
cad/3DPrint/servo/base.stl
cad/3DPrint/servo/washer1.stl
cad/3DPrint/servo/washer2.stl
cad/3DPrint/test/22MotorMount.CATPart
cad/3DPrint/test/FakeWingFrame.CATPart
cad/3DPrint/test/Part1.CATPart
cad/3DPrint/test/fakeBodyPart.CATPart
cad/3DPrint/test/fakeWingSet/rib.CATPart
cad/3DPrint/test/strengthTest.CATPart
cad/Aileron.CATPart
cad/BigGear.CATPart
cad/BodyFrame.CATPart
cad/Part1.CATPart
cad/Part2.CATPart
cad/RibSet.CATPart
cad/Structure/Wing1.CATPart
cad/TiltFrame.CATPart
cad/TiltServo.CATPart
cad/WingGear.CATPart
cad/beam connector.CATPart
cad/gearMount.CATPart
cad/model/model.CATPart
cad/model/model2.CATPart
cad/pdMount.CATPart
cad/pdShaft.CATPart
cad/servo.CATPart
