cfrpg/Phibochilai-X/doc/WingWiring.png

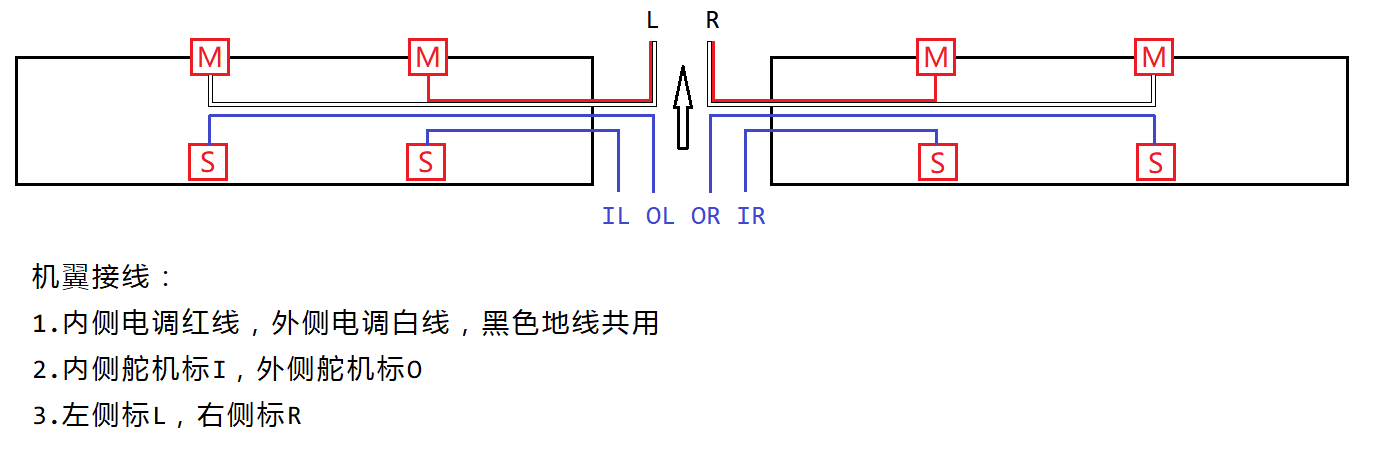
doc/WingWiring.png
