cfrpg/Phibochilai-X/doc/PLAAnnealTest.md

# PLA退火试验

## 试验方法
打印100\*10\*3mm的测试件，使用烤箱加热一定时间，冷却后测试刚度和耐热性能。

## 试验1

### 条件
110度，下管加热，80度测试。

### 测试件
1. 对照
2. 对照
3. 60min-正-室温
4. 60min-反-室温
5. 60min-正-冷藏
6. 60min-反-冷藏
7. 90min-正-室温
8. 90min-正-冷藏
9. 加热板-正
10. 加热板-反
