cfrpg/Phibochilai-X/(commit log)

2018-02-08 我永远喜欢螃蟹公.jpg
    随便push一发,开学见
2018-02-13 Add some airfoils.
    只是试一下能不能push上去orz
2018-02-26 祝大家苟年大吉吧
    [model.CATPart, worm.CATPart, worm.stl, 计算器.xlsx]
2018-03-01 日常更新
    [计算器.xlsx, 重量估算.xlsx]
2018-03-02 只要动力足,缝纫机飞上天
    [计算器.xlsx, 重量估算.xlsx]
2018-03-03 test 3d printer
    [fakebeam.stl, fakesleeve.stl, fakesleevecap.stl, gear.stl, reinforcedRib.stl, rib.CATPart, tiltgear.stl]
2018-03-04 要好就要多加钱——刘光磊
    [重量估算.xlsx]
2018-03-07 Add new power config
    [重量估算.xlsx]
2018-03-07 八百预算航模吧,万元板机抱回家
    [BOM.xlsx, 计算器.xlsx, 重量估算.xlsx]
2018-06-18 Add prototype model.
    添加了原型机模型，相关总体设计文档后续更新。
    （破项目竟然还没凉？
2018-07-14 Add prototype blueprint.
    [worm.CATPart, worm.stl]
2018-07-14 Update BOM.
    [BOM.xlsx, 重量估算.xlsx]
2018-07-15 Add some 3D print model.
    还编造了方案说明
    [22MotorMount.CATPart, 22MotorMount.stl, BOM.xlsx, Part1.CATPart, compMount.stl, fakeBodyPart.CATPart, fakeBodyPart.stl, strengthTest.CATPart]
2018-07-18 Add fake FEM analysis.
    看个特效就好，认真你就输了
    [Wing1.CATPart]
2018-07-18 Remove ANSYS project.
    删工程保流量orz仅保留结果图（特效）
2018-07-22 Update Kaniko.
    感人
    [BOM.xlsx, FakeWingFrame.CATPart, fakeWingFrame.stl]
2018-07-29 Add rib set.
    增加了翼肋组的模型和切割图，机翼弦长调整为0.2m，重新配平。
    [RibSet.CATPart]
2018-07-30 Add plane model.
    [model.CATPart, model.igs]
2018-08-24 打扫卫生，停工一天
    磨刀不误砍柴工？
    [Aileron.CATPart, aile.stl, aile1.stl, aile2.stl, bc.stl, beam connector.CATPart, servo.CATPart, servo.stl]
2018-08-27 Add tilt servo.
    [TiltServo.CATPart, hole.stl, ts1.stl, tsbase.stl, tscap.stl, tspad.stl, tssp.stl]
2018-09-02 Add nothing.
    [TiltServo.CATPart, bc.stl, beam connector.CATPart, biggear.stl, tsbase.stl, tscap.stl]
2018-10-06 Update 一堆东西.
    RT
    [BigGear.CATPart, TiltServo.CATPart, WingGear.CATPart, base.stl, base3.stl, bc.stl, beam connector.CATPart, biggear.stl]
2018-10-30 Update tilt servo.
    [TiltServo.CATPart, model.CATPart]
